cyryllo/Borsuk/docs/sprzet.md

# Sprzęt, połączenia i budowa

## Pliki projektu

- **MakerWorld** – robot *Badger* (Borsuk): <https://makerworld.com/en/models/2668556-badger-robot-for-micro-bit>
  (pliki do cięcia, plik STEP do dalszego rozwoju, STL obudowy pilota)
- **Printables** – obudowa pilota (Handle Joystick for micro:bit, Keyestudio):
  <https://www.printables.com/model/40102-handle-joystick-for-microbit-module-from-keyestudi>
- DXF robota v2 jest też w tym repozytorium: [`hardware/Borsuk_v2.dxf`](../hardware/Borsuk_v2.dxf)

## Lista części (robot v2)

| Część | Ilość | Uwagi |
|---|---|---|
| Sklejka 3 mm | arkusz min. 160 × 370 mm | do cięcia laserem, plik [`Borsuk_v2.dxf`](../hardware/Borsuk_v2.dxf) |
| Klej do drewna | | do sklejenia korpusu |
| BBC micro:bit V1 lub V2 | 1 | V2 zalecany (więcej pamięci, głośnik) |
| Waveshare **Motor Driver for micro:bit** (nr 15220) | 1 | sterownik 2 silników DC + 3 złącza serw, np. [Botland](https://botland.com.pl/microbit-rozszerzenia/13303-sterownik-2-silnikow-i-3-serwomechanizmow-i2c-dla-bbc-microbit-waveshare-15220-5904422320447.html) |
| Silnik z przekładnią, wał dwustronny (*Dual Shaft Gear Motor*, „żółty TT”) z kołem | 2 | wersja v1: 2 × serwo 360° |
| Czujnik odległości **RCW-0001** | 1 | ultradźwiękowy, TRIG/ECHO, pracuje przy 3,3 V |
| Koszyk na 2 × 18650 (połączenie szeregowe) | 1 | |
| Akumulator Li-ion 18650 | 2 | razem ok. 7,4 V |
| Śruba M3 × 25 | 4 | mocowanie silników |
| Śruba M3 × 10 | 4 | mocowanie sterownika silników |
| Nakrętka M3 | 4 | |
| Przewody | | czujnik ↔ płytka sterownika, zasilanie |

### Pilot (opcjonalnie)

| Część | Ilość | Uwagi |
|---|---|---|
| BBC micro:bit V1 lub V2 | 1 | drugi micro:bit |
| **Keyestudio KS0296** Joystick Breakout Board for micro:bit | 1 | joystick + 6 przycisków, gniazdo DC 4,75–12 V |
| Obudowa z drukarki 3D | 1 | STL na Printables / MakerWorld (linki wyżej) |

## Wycinanie i składanie

- Plik: [`hardware/Borsuk_v2.dxf`](../hardware/Borsuk_v2.dxf), jednostki **mm**, wszystkie
  części na jednym arkuszu **148 × 360 mm**. Podgląd: [`hardware/Borsuk_v2_podglad.svg`](../hardware/Borsuk_v2_podglad.svg).
- Gniazda na wpusty mają **3 × 7 mm**, więc konstrukcja jest pod sklejkę **3 mm**.
  Przy grubszej/cieńszej sklejce przeskaluj gniazda, nie cały rysunek.
- Części: 2 boki (z otworami na silniki i rzędami otworów montażowych), podstawa,
  przód z „buzią” i otworami na czujnik, tył, perforowana płyta górna,
  drobne elementy (podkładki, zaczepy).

Więcej w [`hardware/README.md`](../hardware/README.md).

Podgląd DXF

## Sterownik silników – Waveshare Motor Driver for micro:bit

Dokumentacja producenta: [Waveshare Wiki – Motor Driver for micro:bit](https://www.waveshare.com/wiki/Motor_Driver_for_micro:bit)

> **Uwaga na opis w sklepach:** niektóre sklepy (np. Botland) podają „interfejs I2C,
> 12 bitów”. To błąd – na schemacie producenta nie ma układu I2C. TB6612FNG jest
> sterowany **bezpośrednio pinami** micro:bita: PWMA = P8, AIN1 = P13, AIN2 = P12,
> PWMB = P16, BIN1 = P14, BIN2 = P15 (STBY na stałe do 3V3). Tak działa ta biblioteka.

| Parametr | Wartość |
|---|---|
| Zasilanie (zacisk VIN) | **6–12 V** (2 × 18650 = 7,4–8,4 V ✔) |
| Sterownik silników | TB6612FNG, 2 kanały |
| Zasilanie serw | 5 V (stabilizator 5 V, do 3 A) |
| Logika / micro:bit | 3,3 V (stabilizator RT9193 – płytka zasila micro:bita) |
| Otwory montażowe | Ø3 mm (śruby M3 × 10) |
| Wymiary | 65 × 36 mm, otwory w rozstawie 57,24 × 28,7 mm |

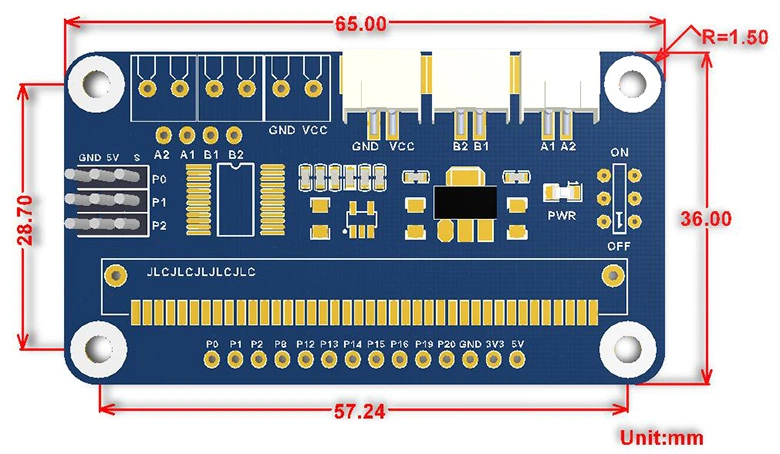
[picture p2: images/waveshare-motor-driver-wymiary.webp]
Sterownik Waveshare – wymiary i złącza


*Rysunek: Waveshare. Wymiary w mm; otwory montażowe Ø3 mm w rozstawie 57,24 × 28,7 mm.*

Złącza na płytce:

| Złącze | Opis |
|---|---|
| VCC / GND (zacisk śrubowy lub wtyk) | zasilanie z koszyka akumulatorów, 6–12 V |
| A1 / A2 | silnik A (lewy) |
| B1 / B2 | silnik B (prawy) |
| S0 / S1 / S2 (z boku, GND / 5V / S) | 3-pinowe złącza serw: sygnał **P0 / P1 / P2**, zasilanie **5 V** |
| Listwa na dole | **P0 P1 P2 P8 P12 P13 P14 P15 P16 P19 P20 GND 3V3 5V** |
| ON / OFF | włącznik zasilania, dioda PWR |

Wolne piny na dolnej listwie (niezajęte przez silniki): **P0, P1, P2, P19, P20**,
plus zasilanie **3V3** i **5V**.

## Połączenia – robot

micro:bit wkłada się w złącze krawędziowe sterownika Waveshare. Piny są stałe:

| Funkcja | Pin micro:bit |
|---|---|
| Silnik A (lewy) – PWM / IN1 / IN2 | P8 / P13 / P12 |
| Silnik B (prawy) – PWM / IN1 / IN2 | P16 / P14 / P15 |
| Serwo S0 (v1: lewe koło) | P0 |
| Serwo S1 (v1: prawe koło) | P1 |
| Serwo S2 (np. „głowa”, chwytak) | P2 |
| Czujnik odległości TRIG / ECHO | dwa wolne piny z dolnej listwy (P0, P1, P2, P19, P20); domyślnie w bibliotece P1 / P2 |

Na listwę sterownika wyprowadzone są wolne piny P0, P1, P2, P19, P20. Pozostałe piny
micro:bita (P3–P7, P9–P11) nie są wyprowadzone na płytkę – są dostępne tylko przez złącze
krawędziowe micro:bita.

### Czujnik odległości RCW-0001

Borsuk używa czujnika **RCW-0001**: działa przy 3,3 V, więc podłącza się go bezpośrednio
do micro:bita, bez dzielnika napięcia. Ma 4 wyprowadzenia: VCC, TRIG, ECHO, GND.
Sygnały TRIG i ECHO podłącz do wolnych pinów na złączu płytki sterownika, a w programie
ustaw te same piny blokiem `czujnik odległości TRIG … ECHO …`
(MicroPython: `robot.set_distance_sensor(trig, echo)`).

Na dolnej listwie sterownika są wolne piny **P0, P1, P2, P19, P20** oraz **3V3** i **GND** –
tam podłącza się czujnik:

| RCW-0001 | Listwa sterownika |
|---|---|
| VCC | **3V3** |
| GND | GND |
| TRIG | wolny pin, np. P1 |
| ECHO | wolny pin, np. P2 |

Zasilanie z **3V3** jest bezpieczne – ECHO oddaje wtedy 3,3 V.

**Nie wiesz, na których pinach jest czujnik?** Wgraj wykrywacz
([MakeCode](../examples/makecode/08-znajdz-piny-czujnika.ts) /
[MicroPython](../examples/micropython/07_znajdz_piny_czujnika.py)), postaw rękę
10–50 cm przed czujnikiem i wciśnij A. Na wyświetlaczu pojawi się np. `T0 E1 23`
= TRIG na P0, ECHO na P1, 23 cm. Potem ustaw te piny blokiem
`czujnik odległości TRIG … ECHO …` na początku programu
(domyślnie biblioteka używa TRIG = P1, ECHO = P2). Wykrywacz sprawdza P0, P1, P2, P19 i P20.

Jeśli czujnik jest na **P19/P20** i robot ma micro:bita **V1**: te piny są tam wspólne z
wewnętrzną magistralą I²C (akcelerometr, kompas) – pomiar może je zakłócać. Na V2 problemu nie ma.

Jeśli czujnik jest na **S0 (P0)**: micro:bit V2 gra dźwięk także na P0, więc bloki
*Muzyka* w robocie mogą zakłócać pomiar. W takim robocie nie graj melodii albo
przełóż czujnik na S1/S2.

> **Uwaga:** środkowy pin bocznych złączy serw i pin **5V** listwy dają **5 V**. Jeśli
> czujnik jest zasilany z 5 V, sprawdź miernikiem, czy ECHO nie oddaje 5 V – micro:bit
> toleruje maks. ok. 3,6 V. Najbezpieczniej: VCC czujnika do **3V3**.

> *Do potwierdzenia: piny czujnika w robotach FabLabu (wykrywacz powyżej) i skąd jest zasilany.*

**Uwaga przy zamiennikach:** klasyczny **HC-SR04** wymaga 5 V i oddaje na ECHO sygnał
**5 V**, który może **uszkodzić micro:bita** (wejścia tolerują maks. 3,6 V). Jeśli nie masz
RCW-0001, wybierz **HC-SR04P** lub **RCWL-1601** (oba działają przy 3,3 V), daj dzielnik
napięcia na ECHO (np. 1 kΩ + 2 kΩ) albo użyj czujnika **Grove Ultrasonic Ranger**
(jeden pin sygnałowy – w bloku ustaw TRIG = ECHO).

## Pilot

Pilot to moduł **Keyestudio KS0296 Joystick Breakout Board for micro:bit** w drukowanej
obudowie ([Printables](https://www.printables.com/model/40102-handle-joystick-for-microbit-module-from-keyestudi)).
Dokumentacja producenta: [KS0296 – docs.keyestudio.com](https://docs.keyestudio.com/projects/KS0296/en/latest/docs/KS0296.html).
Poniższy pinout jest z nią zgodny.

Pilot z joystickiem

| Element | Pin micro:bit |
|---|---|
| Przycisk góra | P10 |
| Przycisk dół | P8 |
| Przycisk lewo | P11 (= przycisk B micro:bita) |
| Przycisk prawo | P9 |
| Select | P7 |
| Mode | P6 |
| Joystick X / Y | P4 / P3 |
| Wciśnięcie joysticka | P5 (= przycisk A micro:bita) |
| Buzzer (jeśli jest w Twojej wersji / obudowie) | P0 |

Piny P3, P4, P6, P7, P9 i P10 są współdzielone z **wyświetlaczem LED** micro:bita,
dlatego biblioteka **wyłącza wyświetlacz** w pilocie. Nie używaj w pilocie bloków
wyświetlacza; zamiast tego używaj dźwięku (buzzer na P0, bloki *Muzyka*).

Na płytce jest też osobne złącze **3V, G, P0, P1** (np. do modułu Bluetooth/UART).
Wejście zasilania: gniazdo DC **4,75–12 V** (stabilizator AMS1117 zasila micro:bita).

## micro:bit V1 a V2

- Obie wersje są obsługiwane (MakeCode kompiluje do obu).
- **V1** potrafi jednocześnie generować PWM tylko na ograniczonej liczbie pinów
  (w praktyce 3). Wystarcza to na 2 silniki + 1 serwo albo 2 serwa kół + 1 serwo.
  Jeśli serwo zaczyna „wariować”, gdy jadą silniki, to właśnie ten limit.
- **V2** gra dźwięk jednocześnie na głośniku i na pinie **P0**. W robocie P0 to serwo S0,
  więc w robocie v1 (serwa kół na S0/S1) nie używaj bloków *Muzyka* – koło by „tańczyło”.
  W pilocie to zaleta: buzzer pilota jest właśnie na P0.

## Zasilanie

- Robot: **2 × 18650 połączone szeregowo** (ok. 7,4 V, do 8,4 V po naładowaniu) do zacisku
  **VIN** sterownika Waveshare (zakres 6–12 V). Sterownik zasila silniki, serwa (5 V)
  i micro:bita (3,3 V).
- Gdy napięcie akumulatorów spadnie poniżej ok. 6 V, sterownik przestaje działać
  stabilnie – pora naładować ogniwa.
- Używaj ogniw z zabezpieczeniem (PCB) i ładuj je ładowarką do Li-ion. Nie zostawiaj
  robota z włączonym zasilaniem bez nadzoru.
- Gdy robot „resetuje się” przy ruszaniu, akumulatory są rozładowane.
- Pilot można zasilać z USB, z koszyka 2 × AAA micro:bita albo z gniazda DC płytki KS0296 (4,75–12 V).
