cyryllo/Borsuk/images/borsuk-v2-wizualizacja.webp

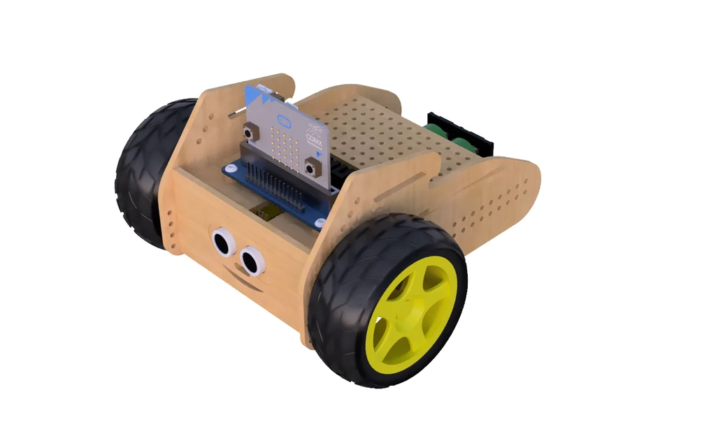
images/borsuk-v2-wizualizacja.webp
