cyryllo/Borsuk/images/roboty.webp

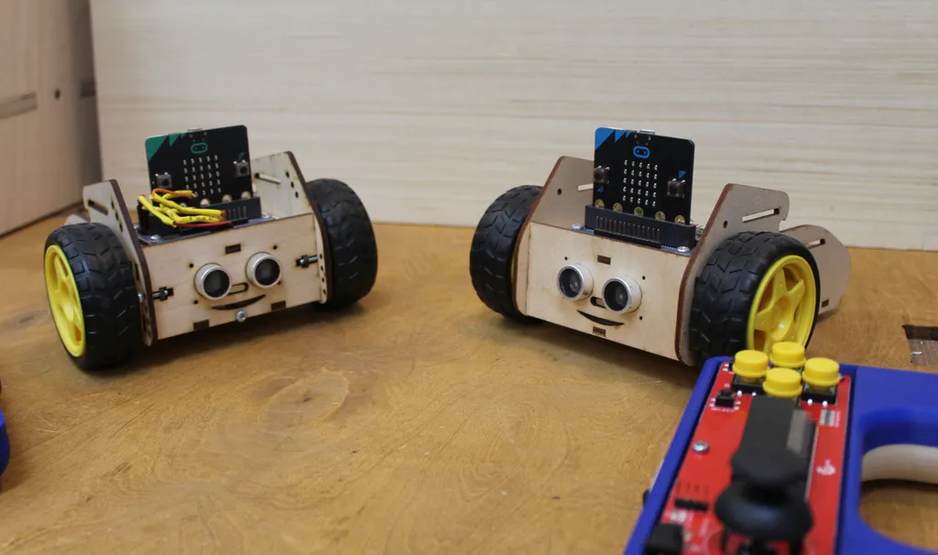
images/roboty.webp
