cyryllo/Borsuk/hardware/Borsuk_v2.dxf

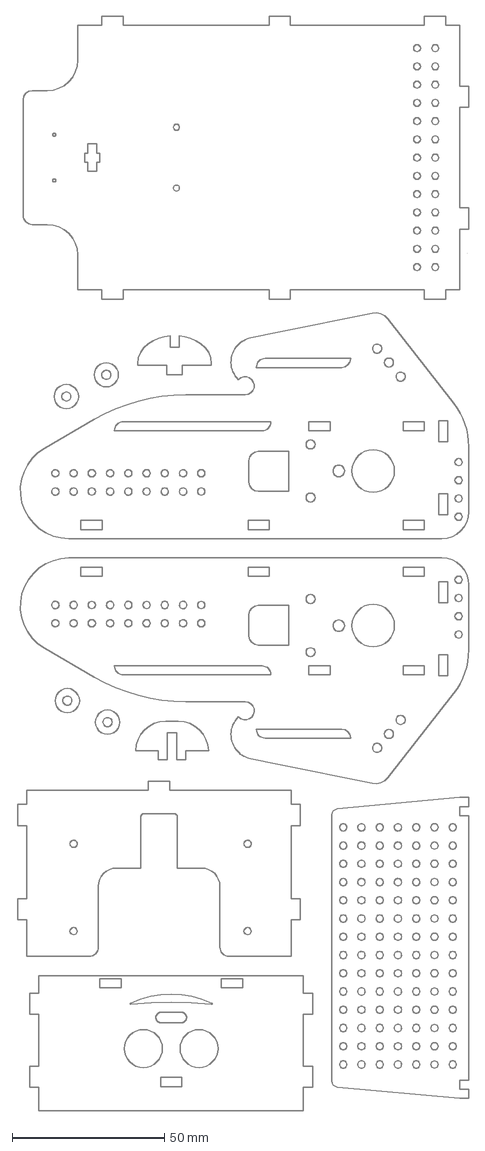
[picture p5: CAD file, 2026-11-11]
hardware/Borsuk_v2.dxf
148.8 x 360.0 mm
