cyryllo/Borsuk/examples/makecode/README.md

**English** | [Polski](README.pl.md)

# MakeCode examples

To open an example: [makecode.microbit.org](https://makecode.microbit.org) → new project → **Extensions** →
`https://github.com/cyryllo/Borsuk` → switch to **JavaScript** → paste the `.ts` file → switch back to **Blocks**.

Images are generated with [`tools/render_blocks.mjs`](../../tools/render_blocks.mjs).

## [01-first-drive.ts](01-first-drive.ts)

**micro:bit:** robot – A = drive there and back, B = stop

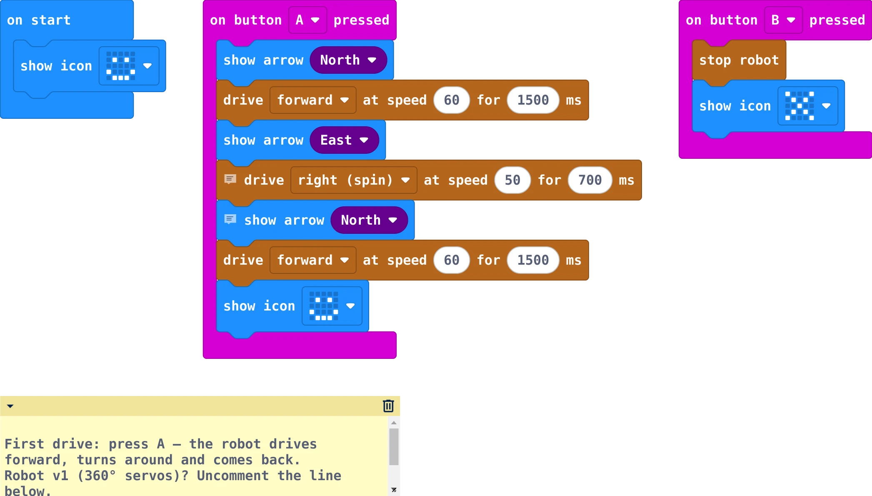
[picture p6: images/blocks/en/01-first-drive.webp]
01-first-drive


## [02-square.ts](02-square.ts)

**micro:bit:** robot – drive in a square

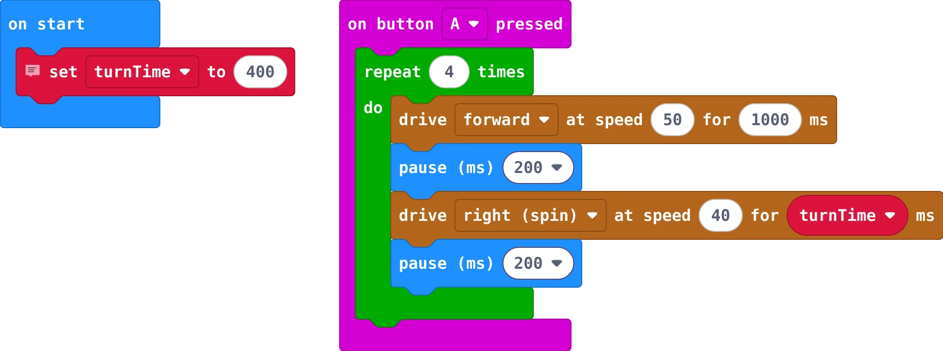
[picture p7: images/blocks/en/02-square.webp]
02-square


## [03-remote.ts](03-remote.ts)

**micro:bit:** remote – send joystick and buttons to the robot

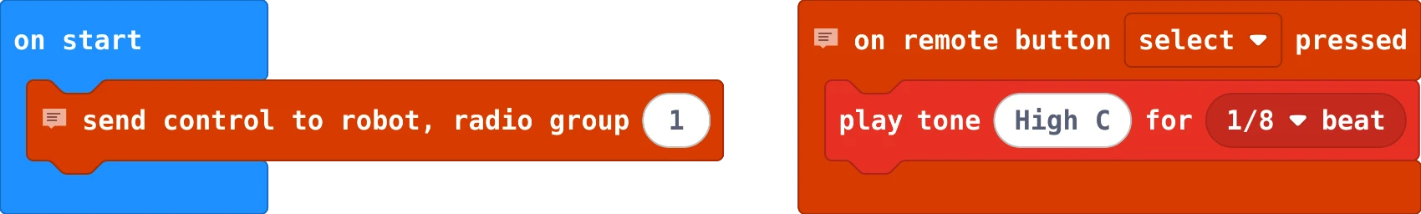
[picture p8: images/blocks/en/03-remote.webp]
03-remote


## [04-remote-robot.ts](04-remote-robot.ts)

**micro:bit:** robot – remote driving + servo + melody

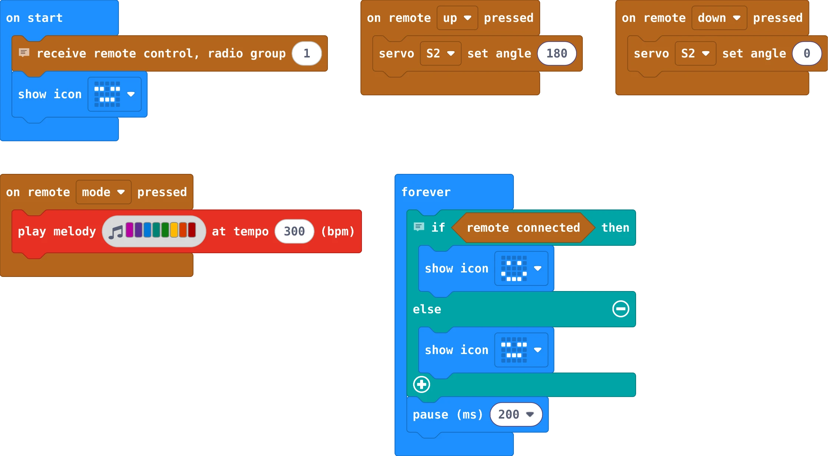
[picture p9: images/blocks/en/04-remote-robot.webp]
04-remote-robot


## [05-obstacle-avoidance.ts](05-obstacle-avoidance.ts)

**micro:bit:** robot – autonomous driving with the distance sensor

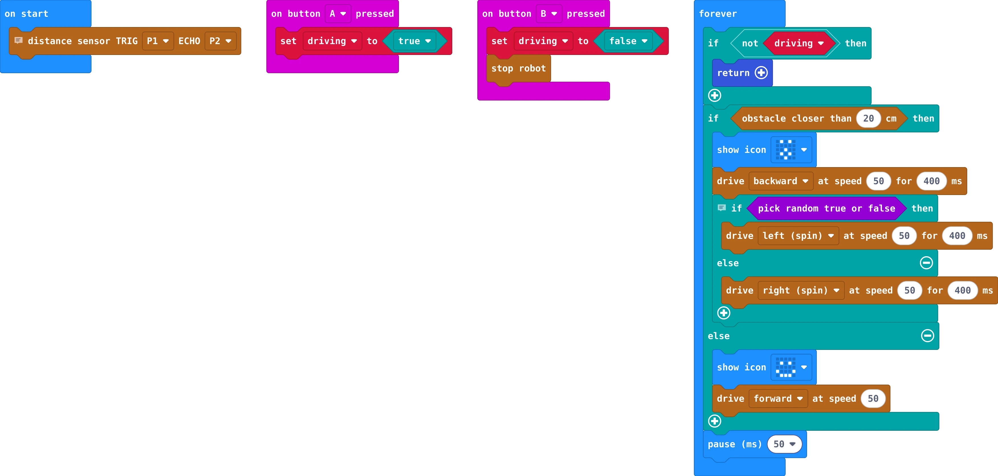
[picture p10: images/blocks/en/05-obstacle-avoidance.webp]
05-obstacle-avoidance


## [06-remote-test.ts](06-remote-test.ts)

**micro:bit:** remote – button and joystick test (sound + console)

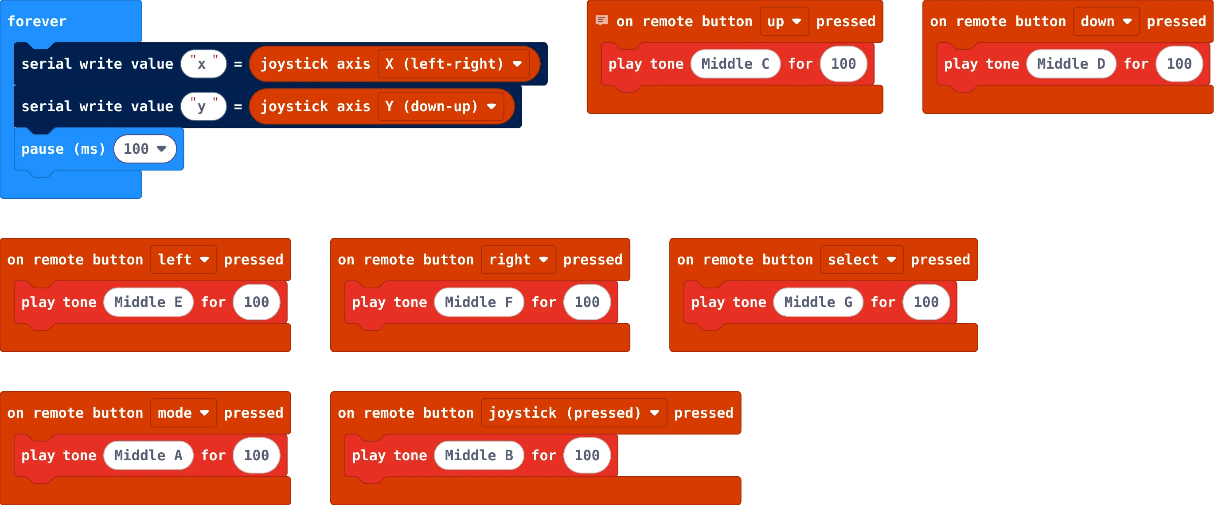
[picture p11: images/blocks/en/06-remote-test.webp]
06-remote-test


## [07-calibration.ts](07-calibration.ts)

**micro:bit:** robot – set wheel directions and 360° servos

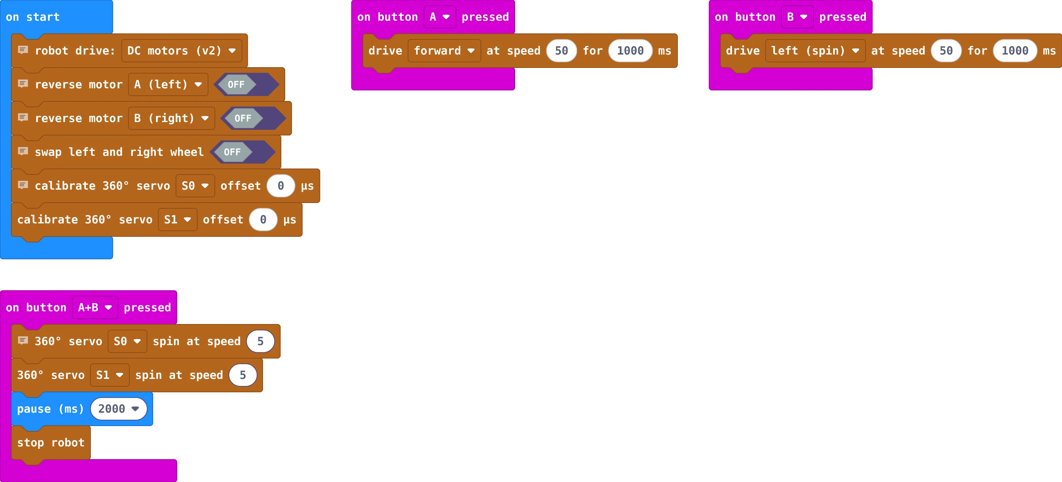
[picture p12: images/blocks/en/07-calibration.webp]
07-calibration


## [08-find-sensor-pins.ts](08-find-sensor-pins.ts)

**micro:bit:** robot – find which pins the distance sensor is on

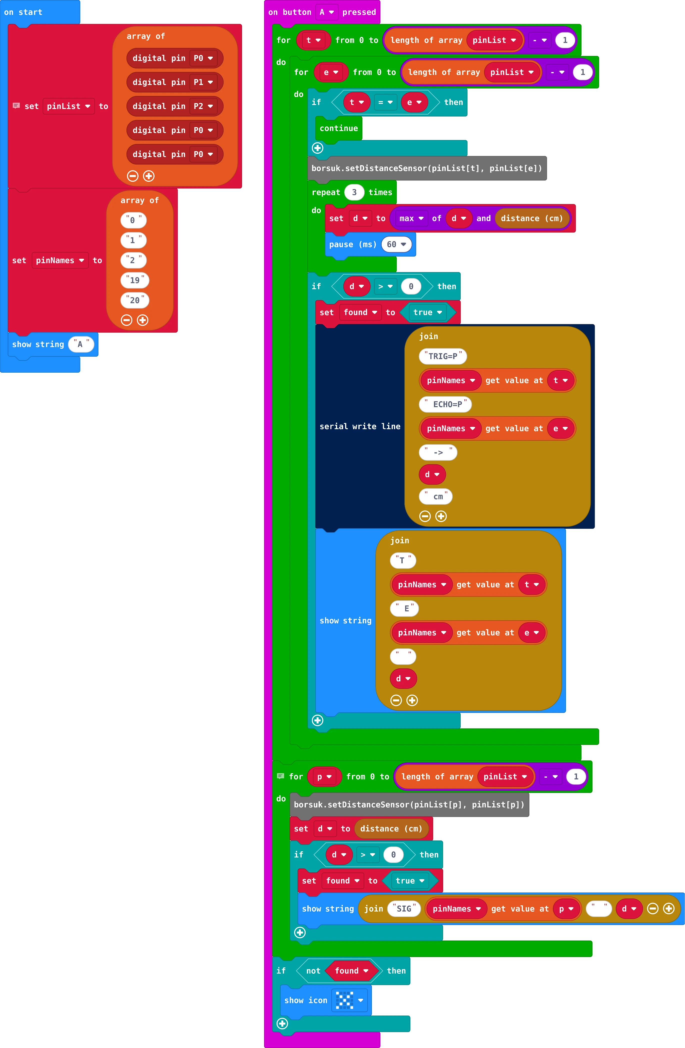
[picture p13: images/blocks/en/08-find-sensor-pins.webp]
08-find-sensor-pins
