cyryllo/Borsuk/examples/makecode/README.pl.md

[English](README.md) | **Polski**

# Przykłady MakeCode

Jak otworzyć przykład: [makecode.microbit.org](https://makecode.microbit.org) → nowy projekt → **Rozszerzenia** →
`https://github.com/cyryllo/Borsuk` → przełącz na **JavaScript** → wklej plik `.ts` → wróć do **Bloków**.
Bloki są po polsku, gdy edytor ma ustawiony język polski.

Obrazki generuje skrypt [`tools/render_blocks.mjs`](../../tools/render_blocks.mjs).

## [01-first-drive.ts](01-first-drive.ts)

**micro:bit:** robot – A = przejazd tam i z powrotem, B = stop

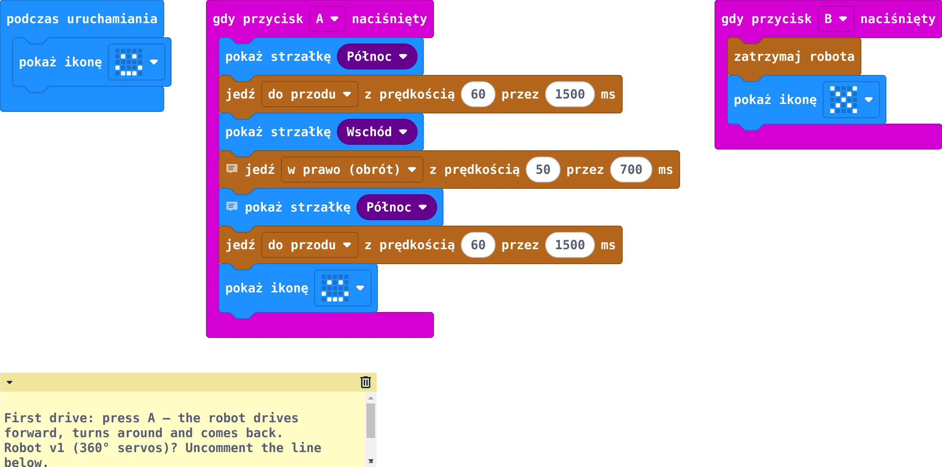
[picture p14: images/blocks/pl/01-first-drive.webp]
01-first-drive


## [02-square.ts](02-square.ts)

**micro:bit:** robot – jazda po kwadracie

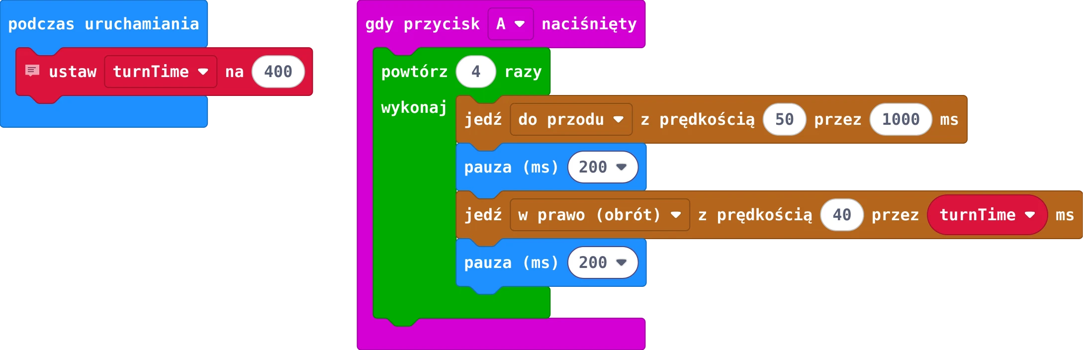
[picture p15: images/blocks/pl/02-square.webp]
02-square


## [03-remote.ts](03-remote.ts)

**micro:bit:** pilot – wysyłanie joysticka i przycisków do robota

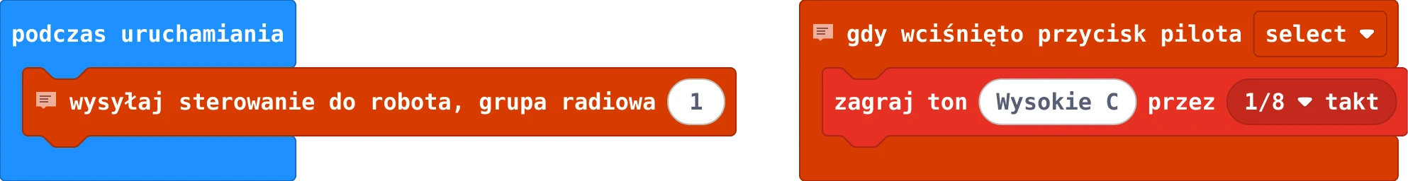
[picture p16: images/blocks/pl/03-remote.webp]
03-remote


## [04-remote-robot.ts](04-remote-robot.ts)

**micro:bit:** robot – jazda pilotem + serwo + melodia

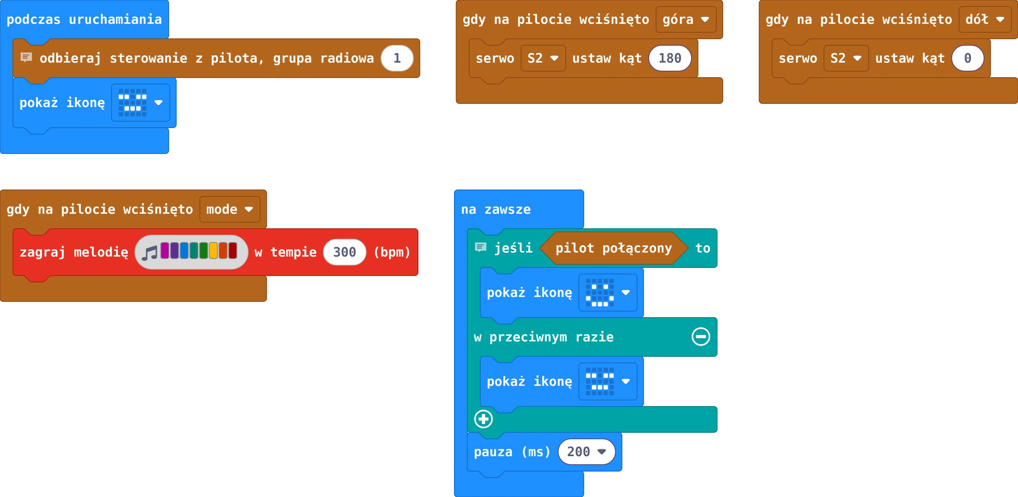
[picture p17: images/blocks/pl/04-remote-robot.webp]
04-remote-robot


## [05-obstacle-avoidance.ts](05-obstacle-avoidance.ts)

**micro:bit:** robot – jazda autonomiczna z czujnikiem odległości

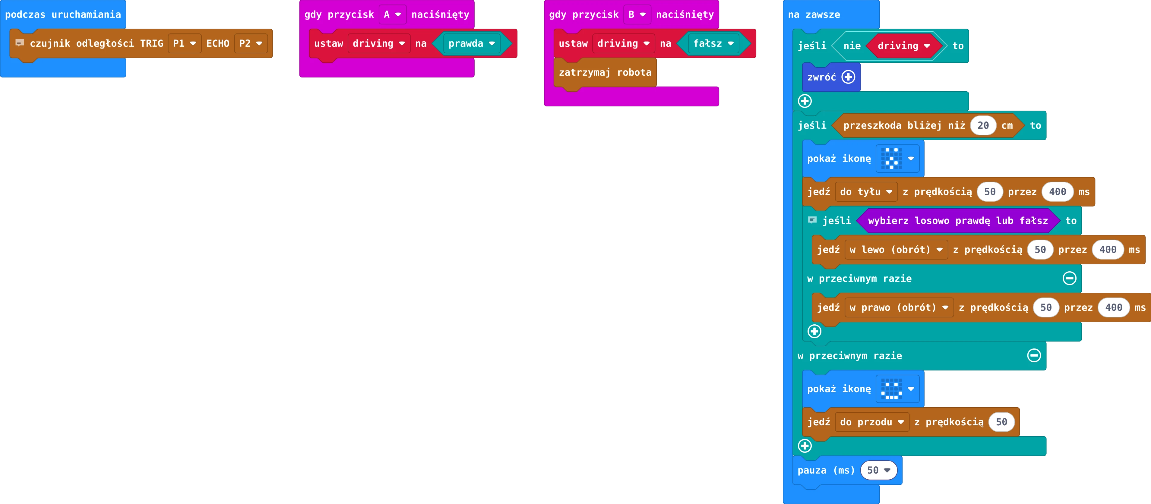
[picture p18: images/blocks/pl/05-obstacle-avoidance.webp]
05-obstacle-avoidance


## [06-remote-test.ts](06-remote-test.ts)

**micro:bit:** pilot – test przycisków i joysticka (dźwięk + konsola)

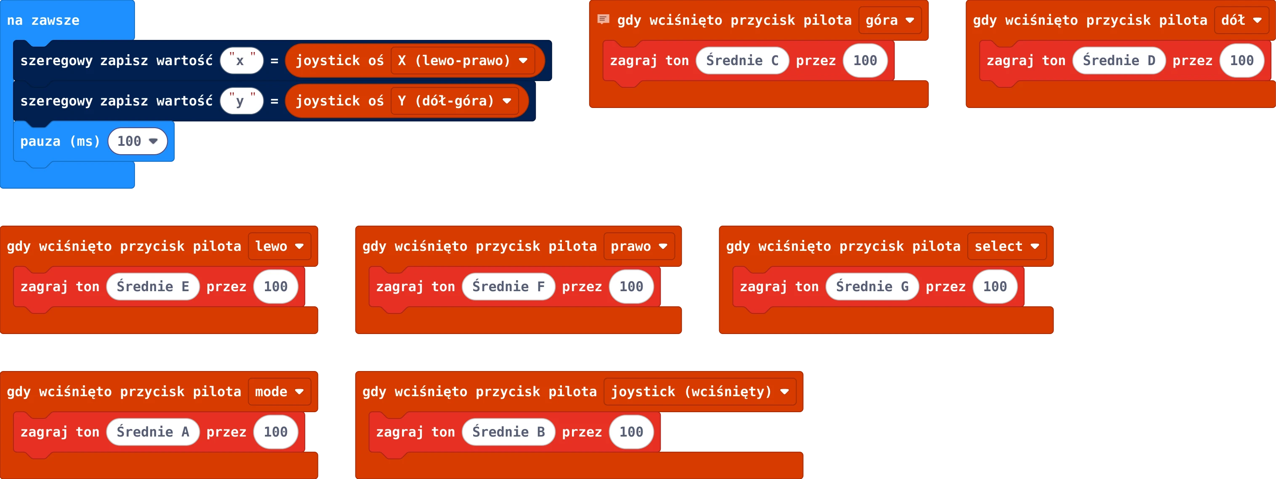
[picture p19: images/blocks/pl/06-remote-test.webp]
06-remote-test


## [07-calibration.ts](07-calibration.ts)

**micro:bit:** robot – ustawianie kierunków kół i serw 360°

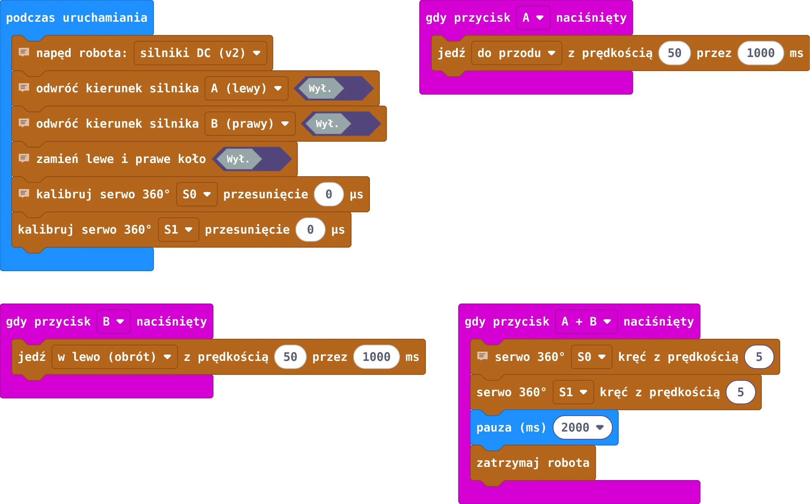
[picture p20: images/blocks/pl/07-calibration.webp]
07-calibration


## [08-find-sensor-pins.ts](08-find-sensor-pins.ts)

**micro:bit:** robot – wykrywanie pinów czujnika odległości

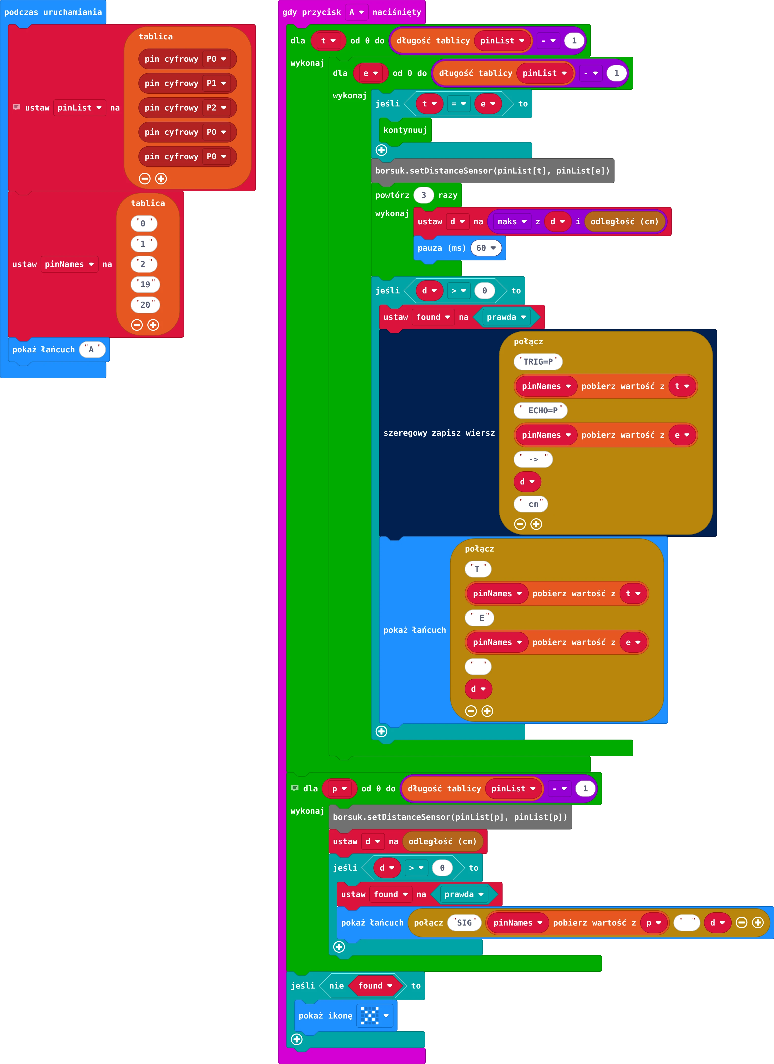
[picture p21: images/blocks/pl/08-find-sensor-pins.webp]
08-find-sensor-pins
