cyryllo/Borsuk/(commit log)

2026-11-11 Dokumentacja: czujnik odległości 3,3 V na wolnych pinach płytki rozszerzeń
2026-11-11 Dokumentacja: pełna lista części (RCW-0001, Keyestudio, 18650, śruby), linki MakerWorld i Printables
2026-11-11 Dokumentacja: pilot Keyestudio KS0296 – pinout potwierdzony z dokumentacją producenta (Web Archive)
2026-11-11 Przykład: wykrywacz pinów czujnika odległości (P0/P1/P2), dokumentacja złączy S0–S2
2026-11-11 Dokumentacja: sterownik sterowany pinami (schemat), nie I2C – sprostowanie opisu sklepu, link do Botland
2026-11-11 English as the main language, Polish translation (v1.1.0)
    - MakeCode blocks in English + full Polish translation in _locales/pl
    (block IDs unchanged, existing programs keep working)
    - docs in English (README.md, docs/), Polish in README.pl.md and docs/pl/
    - examples renamed and translated to English
    - MicroPython: English comments, Pilot.direction() returns English names
    - helper files renamed (tools/dxf_preview.py, images, SVG preview)
    - hardware docs: Kerfly for laser cutting
